ashkumr/PCB_Design/samd51_pinouts.xlsx

PA00 | PB00
PA01 | PB01
PA02 | PB02
PA03 | PB03
PA04 | PB04
PA05 | PB05
PA06 | PB06
PA07 | PB07
PA08 | PB08
PA09 | PB09
PA10 | PB10
PA11 | PB11
PA12 | PB12
PA13 | PB13
PA14 | PB14
PA15 | PB15
PA16 | PB16
PA17 | PB17
PA18 | PB22
PA19 | PB23
PA20 | PB30
PA21 | PB31
PA22
PA23
PA24
PA25
PA26
PA27
