ashkumr/PCB_Design/final_layout.png

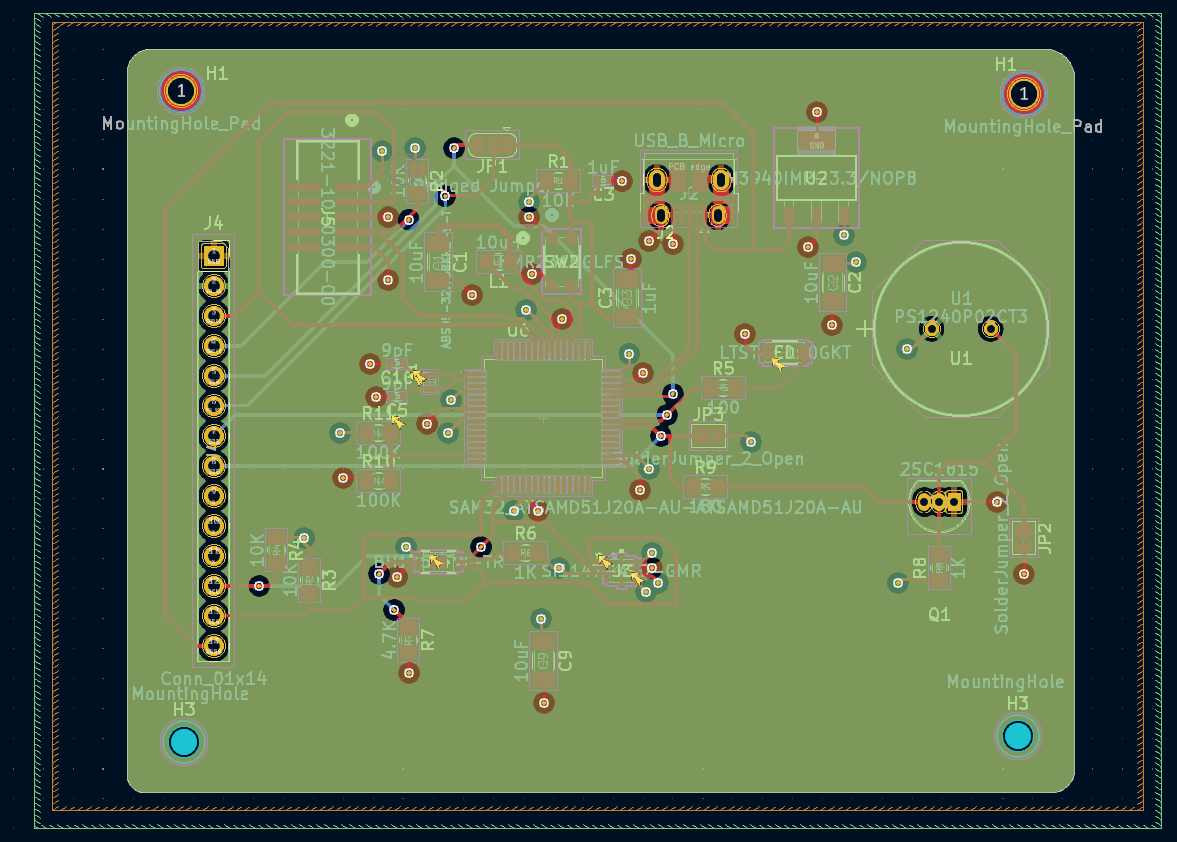
final_layout.png
