ashkumr/PCB_Design/Schematic.png

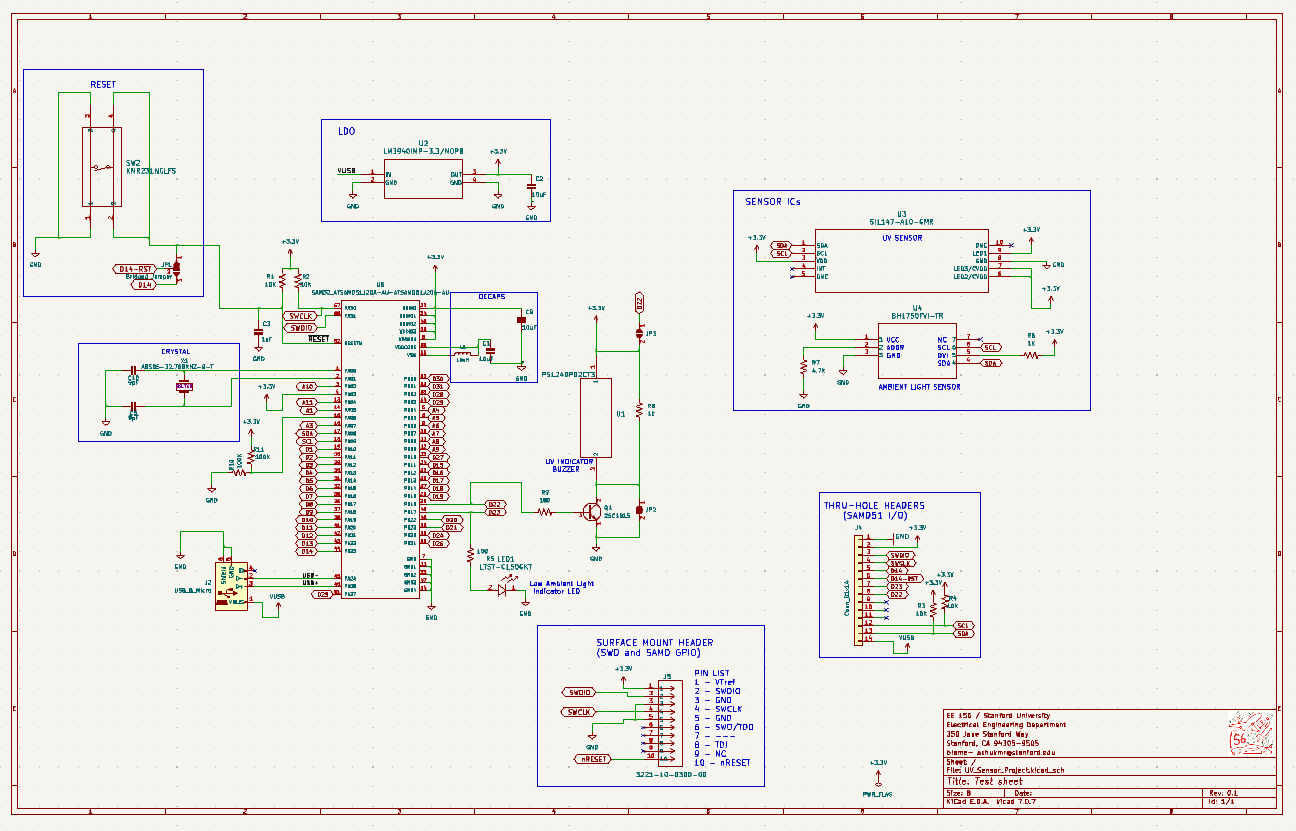
Schematic.png
