ashkumr/PCB_Design/uv_sensor_layout_nets_hidden.png

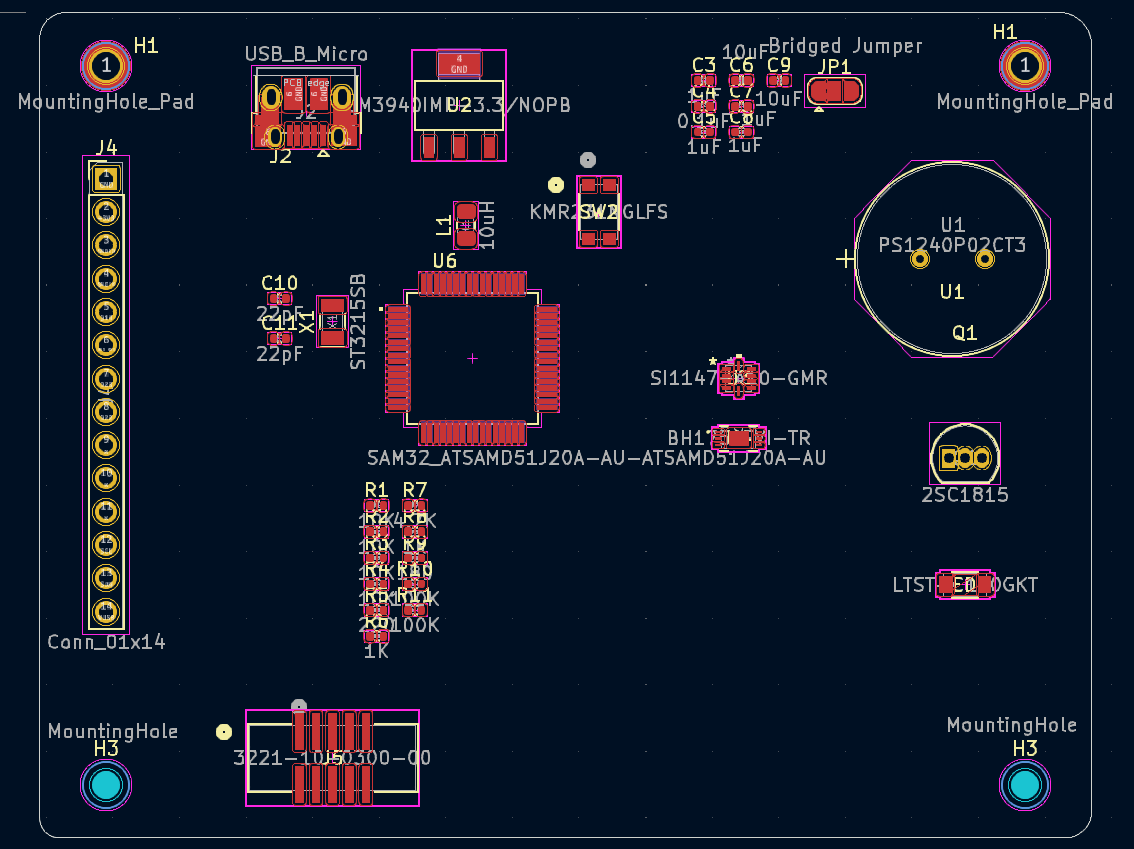
uv_sensor_layout_nets_hidden.png
