ashkumr/PCB_Design/uv_sensor_layout_power_nets_hidden.png

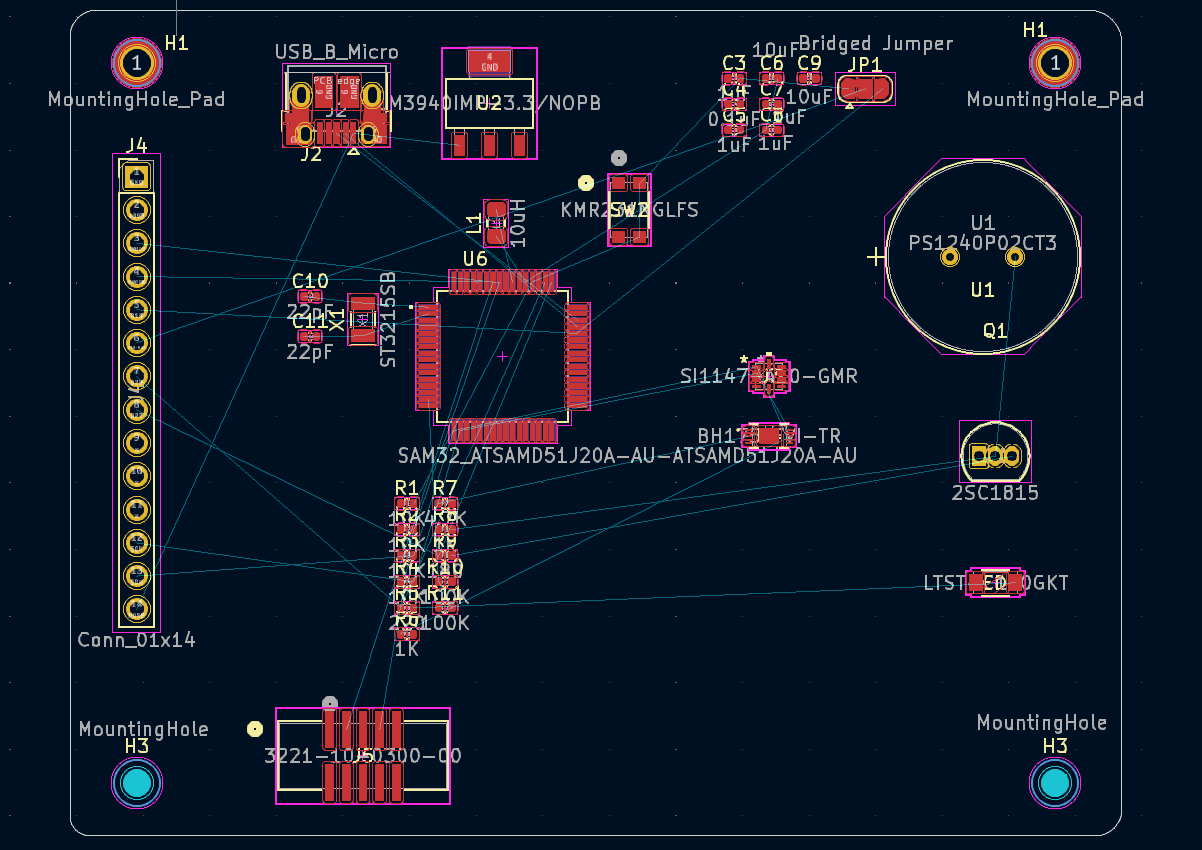
uv_sensor_layout_power_nets_hidden.png
