ashkumr/PCB_Design/schematic.pdf

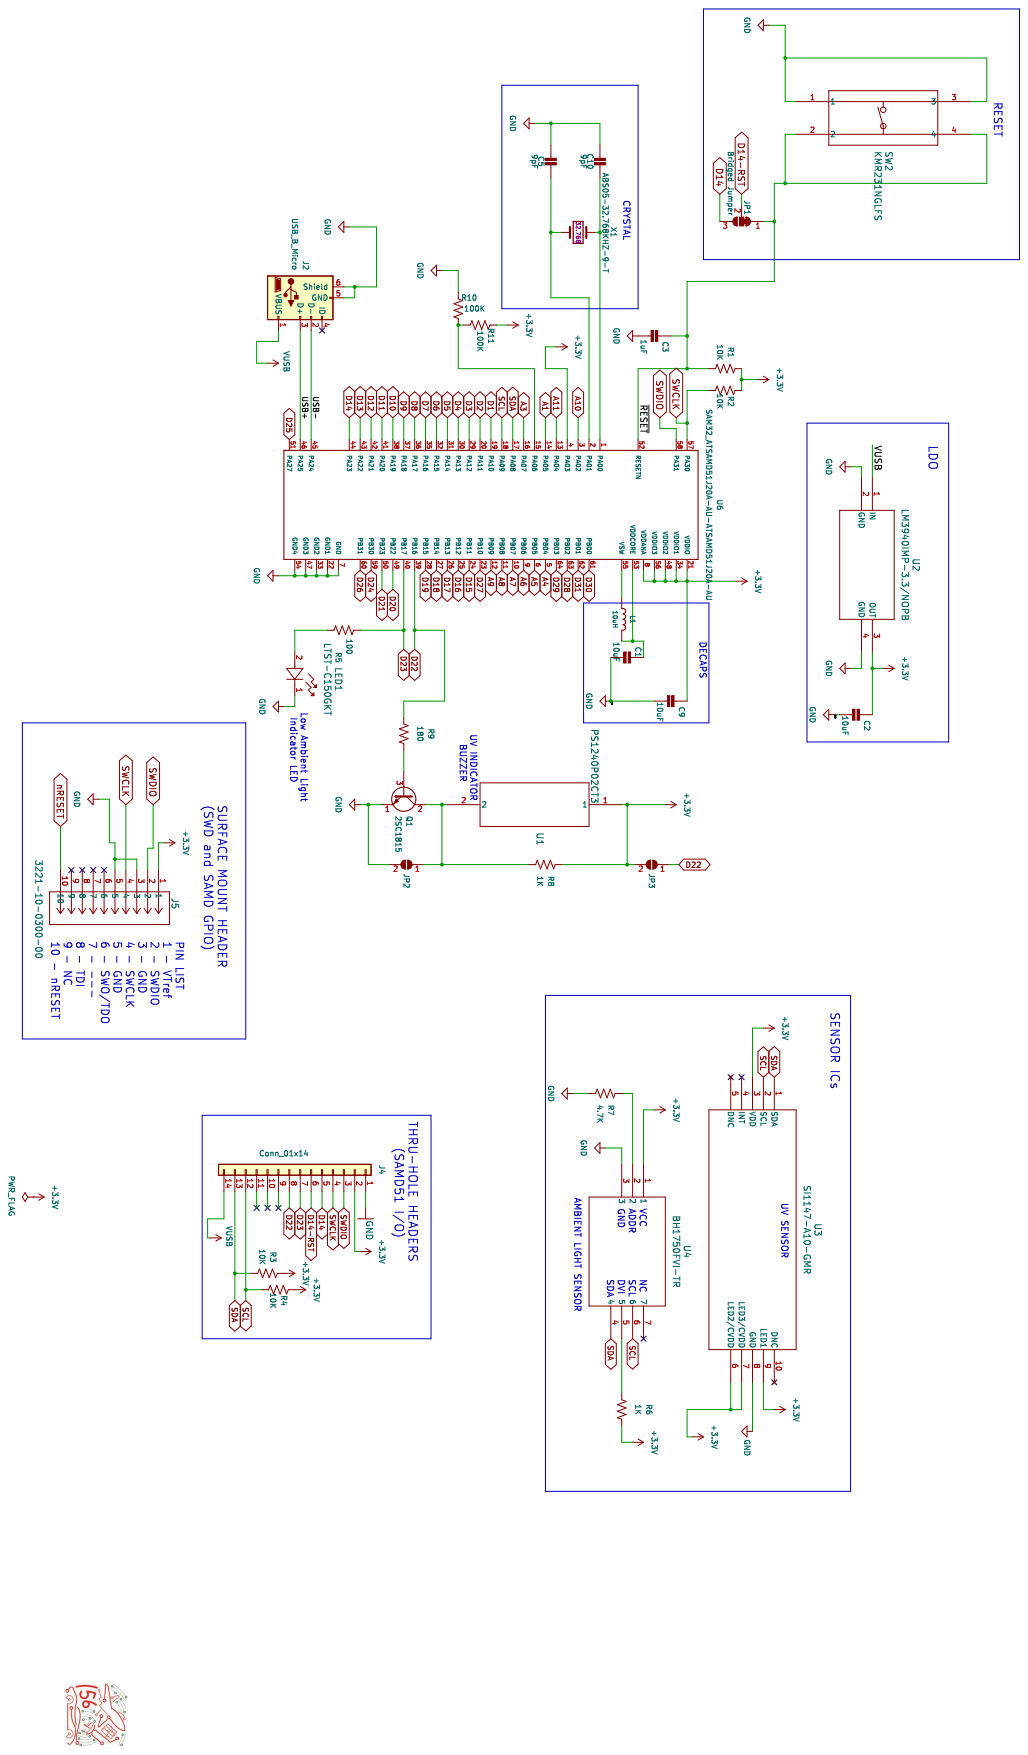
[picture p5: page 1]
