ashkumr/PCB_Design/UV_Sensor_Project.kicad_pcb

## KiCad design UV_Sensor_Project.kicad_pcb (2024-01-02)

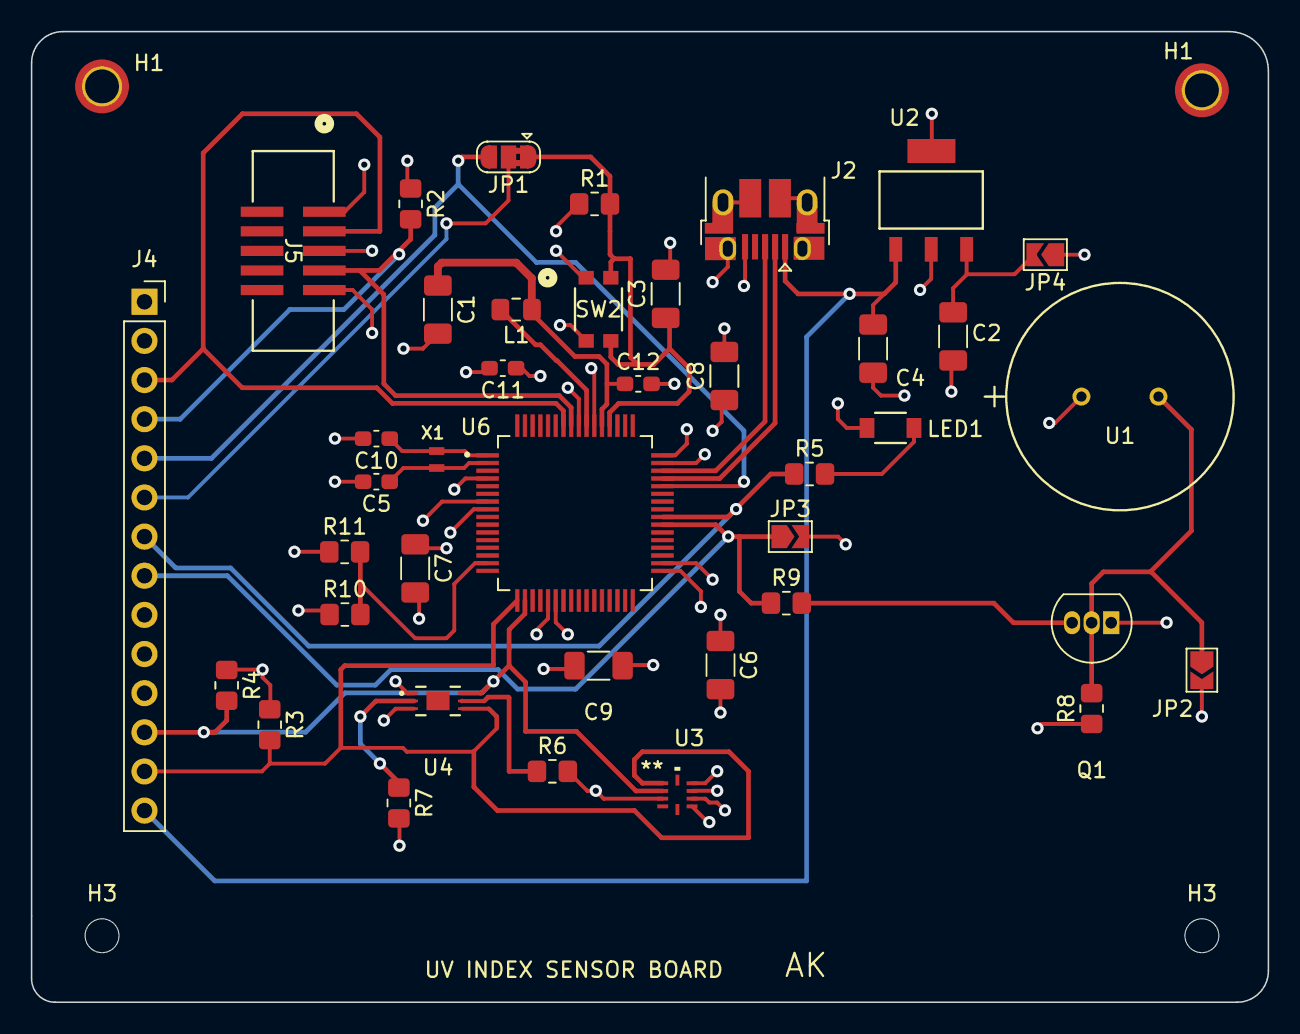
[picture p6: board UV_Sensor_Project.kicad_pcb from above]

Board: 4 copper layers, 80.3 x 63.0 mm, 44 parts (0 on the bottom side), 25 nets.

Parts:
C1, C2, C4, C6, C7, C8, C9: 10uF; C_1206_3216Metric_Pad1.33x1.80mm_HandSolder
C3: 1uF; C_1206_3216Metric_Pad1.33x1.80mm_HandSolder
C5, C10: 9pF; C_0603_1608Metric_Pad1.08x0.95mm_HandSolder
C11, C12: 1uF; C_0603_1608Metric_Pad1.08x0.95mm_HandSolder
H1, H1#2: MountingHole_Pad; MountingHole_2.2mm_M2_ISO7380_Pad_TopBottom
H3, H3#2: MountingHole; MountingHole_2.2mm_M2_ISO7380
J2: USB_B_Micro; USB_Micro-B_Amphenol_10103594-0001LF_Horizontal
J4: Conn_01x14; PinSocket_1x14_P2.54mm_Vertical
J5: 3221-10-0300-00; CONN10_3221-10-0300-00_CNC
JP1: Bridged Jumper; SolderJumper-3_P1.3mm_Bridged2Bar12_RoundedPad1.0x1.5mm
JP2, JP3, JP4: SolderJumper_2_Open; SolderJumper-2_P1.3mm_Open_TrianglePad1.0x1.5mm
L1: 10uH; L_0805_2012Metric_Pad1.15x1.40mm_HandSolder
LED1: LTST-C150GKT; LED_LTST-C150GKT_LTO
Q1: 2SC1815; TO-92_Inline
R1, R2, R3, R4: 10K; R_0805_2012Metric_Pad1.20x1.40mm_HandSolder
R5: 100; R_0805_2012Metric_Pad1.20x1.40mm_HandSolder
R6, R8: 1K; R_0805_2012Metric_Pad1.20x1.40mm_HandSolder
R7: 4.7K; R_0805_2012Metric_Pad1.20x1.40mm_HandSolder
R9: 180; R_0805_2012Metric_Pad1.20x1.40mm_HandSolder
R10, R11: 100K; R_0805_2012Metric_Pad1.20x1.40mm_HandSolder
SW2: KMR231NGLFS; IC4_KMR231NGLFS_CNK
U1: PS1240P02CT3; SMT_PP02CT3_TDK
U2: LM3940IMP-3.3/NOPB; MP04A
U3: SI1147-A10-GMR; QFN10_2X2_SIL
U4: BH1750FVI-TR; BH1750FVI-TR_ROM
U6: SAM32_ATSAMD51J20A-AU-ATSAMD51J20A-AU; QFP50P1200X1200X120-64N
X1: ABS05-32.768KHZ-9-T; XTAL_ABS05-32.768KHZ-9-T

Connections:
+3.3V: C6.1, C7.1, C8.1, C9.1, C11.1, J4.2, J5.1, JP3.2 (B), JP4.1 (A), R1.1, R2.1, R3.1, R4.1, R6.2, R8.1, R11.1, U1.1, U3.3 (VDD), U3.6 (LED2/CVDD), U3.7 (LED3/CVDD), U3.9 (LED1), U4.1, U6.4 (PA03), U6.8 (VDDANA), U6.21 (VDDIO), U6.34 (VDDIO1), U6.48 (VDDIO2), U6.56 (VDDIO3)
/USB+: J2.3 (D+), U6.46 (PA25)
/USB-: J2.2 (D-), U6.45 (PA24)
/~RESET: C3.1, JP1.1 (A), R1.2, SW2.2, SW2.4, U6.52 (RESETN)
D14: J4.5, JP1.3 (B), U6.44 (PA23)
D14-RST: J4.6, JP1.2 (C)
D22: J4.8, JP3.1 (A), R9.1, U6.39 (PB16)
D23: J4.7, R5.1, U6.40 (PB17)
GND: C1.2, C2.2, C3.2, C4.2, C5.2, C6.2, C7.2, C8.2, C9.2, C10.2, C11.2, C12.2, J2.5 (GND), J2.6 (Shield), J4.1, J5.3, J5.5, JP2.2 (B), LED1.1, Q1.1 (E), R7.2, R10.1, SW2.1, SW2.3, U2.2 (GND), U2.4 (GND), U3.8 (GND), U4.3, U6.7 (GND), U6.22 (GND1), U6.33 (GND2), U6.47 (GND3), U6.54 (GND4)
unnamed: JP2.1 (A), Q1.2 (C), R8.2, U1.2
unnamed: C2.1, JP4.2 (B), U2.3 (OUT)
unnamed: LED1.2, R5.2
unnamed: Q1.3 (B), R9.2
unnamed: R6.1, U4.5
unnamed: R7.1, U4.2
unnamed: C10.1, U6.1 (PA00), X1.2
unnamed: C5.1, U6.2 (PA01), X1.1
unnamed: R10.2, R11.2, U6.15 (PA06)
unnamed: C1.1, C12.1, L1.1, U6.53 (VDDCORE)
unnamed: L1.2, U6.55 (VSW)
SCL: J4.12, R4.2, U3.2 (SCL), U4.6, U6.18 (PA09)
SDA: J4.13, R3.2, U3.1 (SDA), U4.4, U6.17 (PA08)
SWCLK: J4.4, J5.4, R2.2, U6.57 (PA30)
SWDIO: J4.3, J5.2, U6.58 (PA31)
VUSB: C4.1, J2.1 (VBUS), J4.14, U2.1 (IN)
